AKstudios/HCHO_logger/hcho_logger_breakdown.jpg

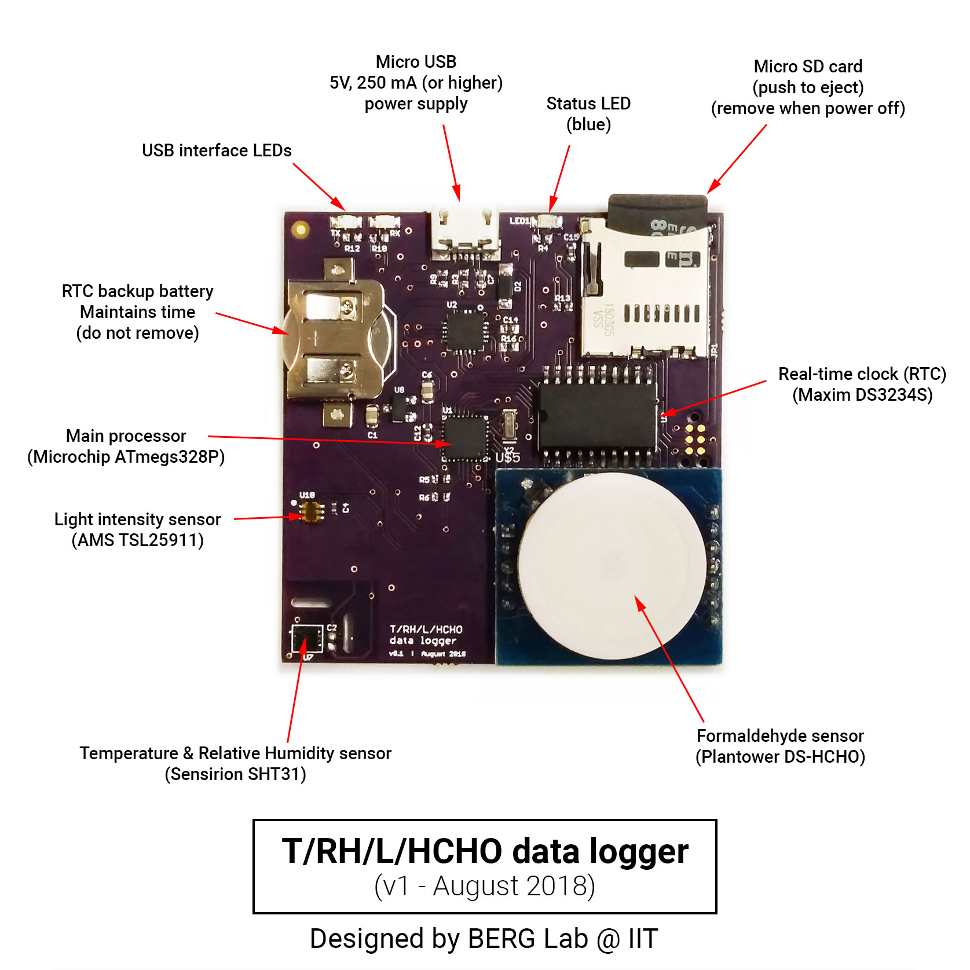
hcho_logger_breakdown.jpg
