AKstudios/HCHO_logger/docs/IMG_20180912_144740.jpg

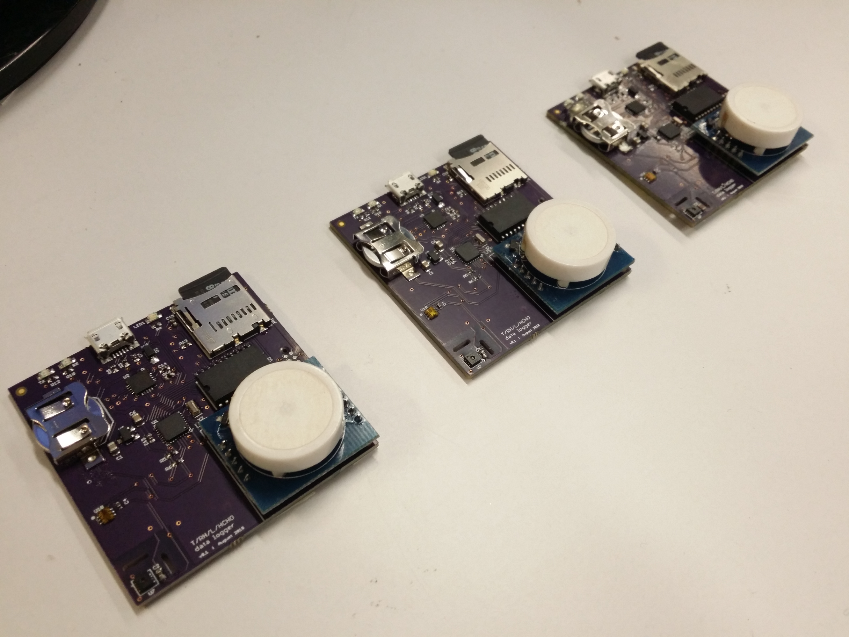
docs/IMG_20180912_144740.jpg
