AKstudios/HCHO_logger/docs/IMG_20180912_144756.jpg

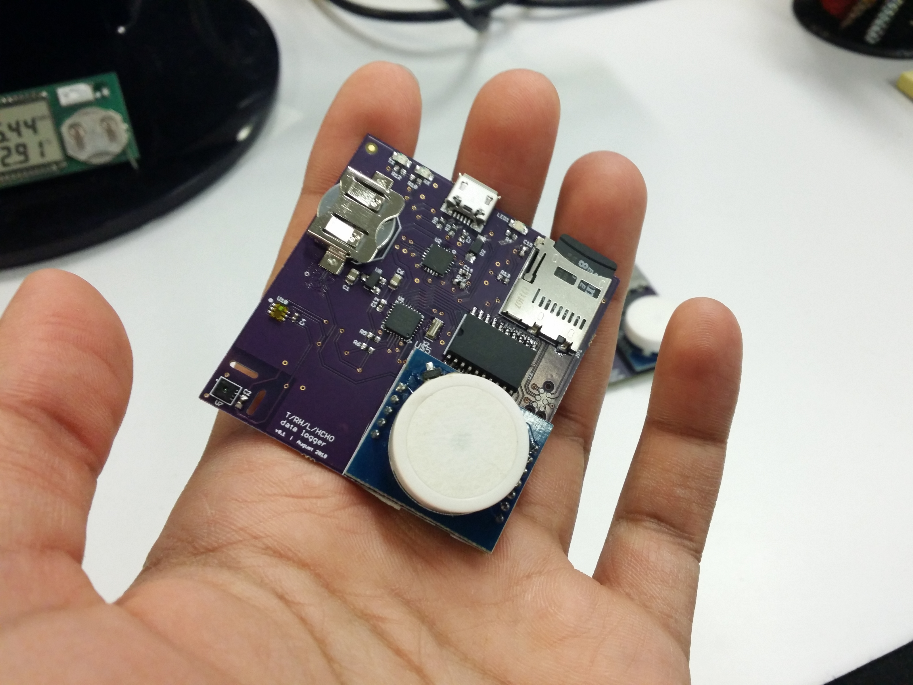
docs/IMG_20180912_144756.jpg
