AKstudios/HCHO_logger/TRHHCHO_datalogger.brd

## EAGLE design TRHHCHO_datalogger.brd (2018-08-14)

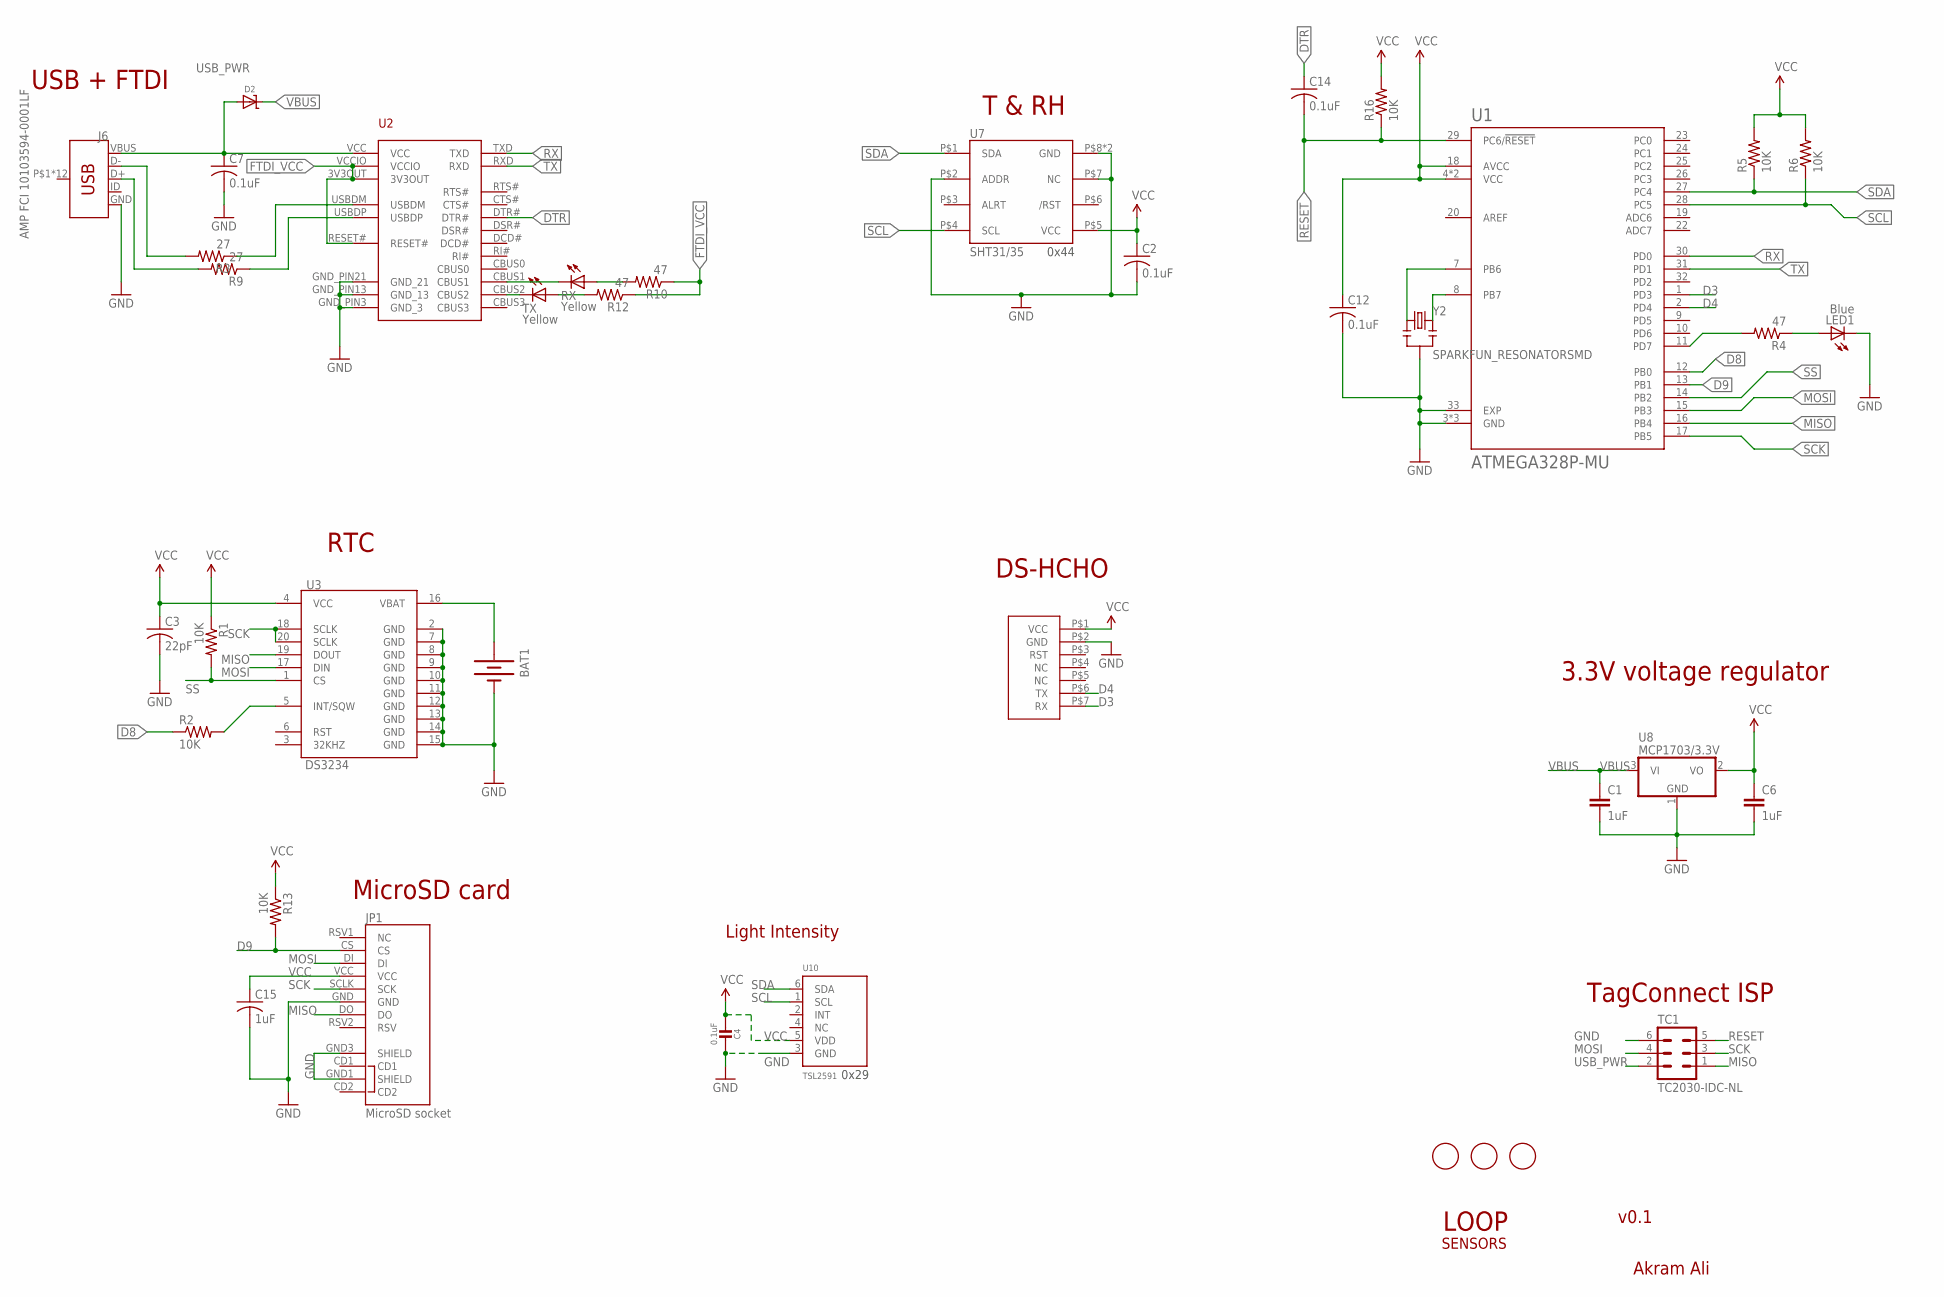
[picture p4: schematic TRHHCHO_datalogger.sch]

Parts:
BAT1: BATTERY12MM; BATTCON_12MM; MPN 3000
C1, C6: 1uF; 0805; MPN CC0805KKX7R7BB105
C2, C7, C12, C14: 0.1uF; C0402
C3: 22pF; C0402
C4: 0.1uF; MICROBUILDER__0402MP; MPN GRM155R71C104KA88J
C15: 1uF; C0402
D2: MICROBUILDER_DIODE-SCHOTTKYSOD-123; MICROBUILDER_SOD-123
J6: AMP FCI 10103594-0001LF; USB-MICROB-PTH
JP1: MicroSD socket; MICRO-SD-SOCKET-PP
LED1: Blue; CHIPLED_0805; MPN 150080BS75000
R1, R2, R5, R6, R13, R16: 10K; R0402
R3, R9: 27; R0402
R4, R10, R12: 47; R0402
RX: Yellow; CHIPLED_0805; MPN LG R971-KN-1
TC1: TC2030-IDC-NL
TX: Yellow; CHIPLED_0805; MPN LH R974-LP-1
U1: ATMEGA328P-MU; QFN50P500X500X100-33N
U2: FT231XQ-R; FTDI_FT231XQ-R_PACKAGE; MPN FT231XQ-R
U3: DS3234; MPN DS3234S#
U7: SHT31/35; SHT3X; MPN SHT31-DIS-B
U8: MCP1703/3.3V; SOT23; MPN MCP1703T-2502E/CB
U10: TSL2591; DFN6_TAOS; MPN TSL25911FN
U$1, U$2, U$3: FIDUCIAL; FIDUCIAL_1MM
U$5: DS_HCHO
Y2: SPARKFUN_RESONATORSMD; SPARKFUN_RESONATOR-SMD

Connections:
D3: U1.1 (PD3), U$5.P$7 (RX)
D4: U1.2 (PD4), U$5.P$6 (TX)
D8: R2.1, U1.12 (PB0)
D9: JP1.CS, R13.2, U1.13 (PB1)
DTR: C14.1, U2.DTR#
FTDI_VCC: R10.1, R12.1, U2.3V3OUT, U2.RESET#, U2.VCCIO
GND: BAT1.GND (-), C1.2, C2.2, C3.2, C4.1, C6.2, C7.2, C12.2, C15.2, J6.GND, JP1.GND, JP1.GND1 (SHIELD), JP1.GND3 (SHIELD), LED1.C, TC1.6, U1.3 (GND), U1.5 (GND), U1.21 (GND), U1.33 (EXP), U2.GND_PIN3 (GND_3), U2.GND_PIN13 (GND_13), U2.GND_PIN21 (GND_21), U3.2 (GND), U3.7 (GND), U3.8 (GND), U3.9 (GND), U3.10 (GND), U3.11 (GND), U3.12 (GND), U3.13 (GND), U3.14 (GND), U3.15 (GND), U7.P$2 (ADDR), U7.P$7 (NC), U7.P$8 (GND), U7.PAD (GND), U8.1 (GND), U10.3 (GND), U$5.P$2 (GND), Y2.2
MISO: JP1.DO, TC1.1, U1.16 (PB4), U3.19 (DOUT)
MOSI: JP1.DI, TC1.4, U1.15 (PB3), U3.17 (DIN)
unnamed: R4.2, U1.11 (PD7)
unnamed: R2.2, U3.5 (INT/SQW)
unnamed: LED1.A, R4.1
unnamed: U1.8 (PB7), Y2.3
unnamed: U1.7 (PB6), Y2.1
unnamed: BAT1.PWR@1 (+), U3.16 (VBAT)
unnamed: RX.C, U2.CBUS1
unnamed: TX.C, U2.CBUS2
unnamed: R3.1, U2.USBDM
unnamed: R9.1, U2.USBDP
unnamed: R10.2, RX.A
unnamed: R12.2, TX.A
unnamed: J6.D-, R3.2
unnamed: J6.D+, R9.2
RESET: C14.2, R16.1, TC1.5, U1.29 (PC6/!RESET)
RX: U1.30 (PD0), U2.TXD
SCK: JP1.SCLK (SCK), TC1.3, U1.17 (PB5), U3.18 (SCLK), U3.20 (SCLK)
SCL: R6.1, U1.28 (PC5), U7.P$4 (SCL), U10.1 (SCL)
SDA: R5.1, U1.27 (PC4), U7.P$1 (SDA), U10.6 (SDA)
SS: R1.2, U1.14 (PB2), U3.1 (CS)
TX: U1.31 (PD1), U2.RXD
USB_PWR: C7.1, D2.A, J6.VBUS, TC1.2, U2.VCC
VBUS: C1.1, D2.C, U8.3 (VI)
VCC: C2.1, C3.1, C4.2, C6.1, C12.1, C15.1, JP1.VCC, R1.1, R5.2, R6.2, R13.1, R16.2, U1.4 (VCC), U1.6 (VCC), U1.18 (AVCC), U3.4 (VCC), U7.P$5 (VCC), U8.2 (VO), U10.5 (VDD), U$5.P$1 (VCC)

Notes on the sheet:
T & RH
3.3V voltage regulator
LOOP
Akram Ali
USB + FTDI
0x44
MicroSD card
RTC
v0.1
SENSORS
TagConnect ISP
DS-HCHO
Light Intensity
0x29

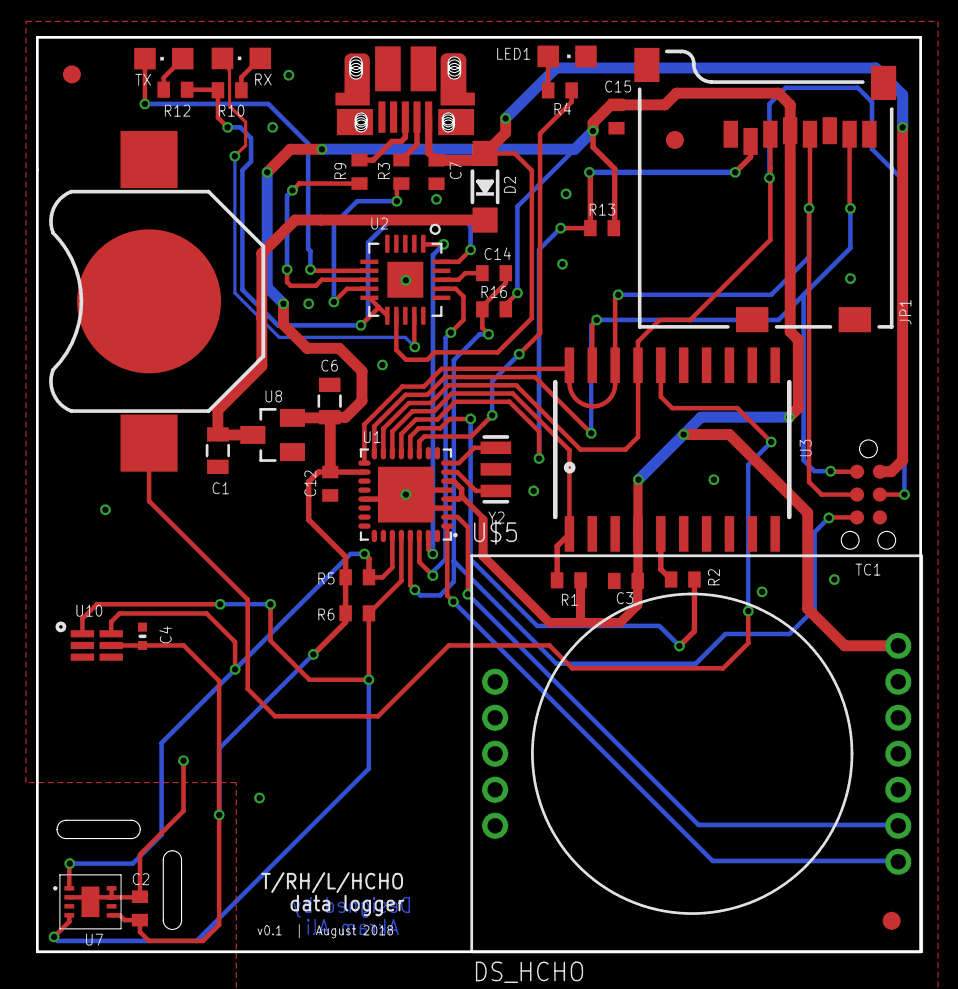
[picture p5: board TRHHCHO_datalogger.brd from above]

Board: 2 copper layers, 49.1 x 50.8 mm, 39 parts (0 on the bottom side), 33 nets.
