AKstudios/HCHO_logger/(commit log)

2018-08-14 Updated footprint of HCHO sensor
    - Now using proper dimensions given by manufacturer
    - Small trace adjustments
    [TRHHCHO_datalogger.brd, TRHHCHO_datalogger.sch]
2018-08-14 minor component placement update
    - moved some traces and components so they dont' overlap with silkscreen and keepout
    - ERC/DRC
    [TRHHCHO_datalogger.brd]
2018-09-06 Firmware updated
    - Now using NeoSWserial library for software serial (more reliable than software serial)
    - Removed ISR declaration from code (library has it declared)
    - Added code for HCHO sensor
    - Cleaned up code and verified that it works for the board
2018-11-21 Added supporting docs
    [data.csv, data2.csv]
